ItsLuxer/DRL/Diseños MK1/Dron Simulacion para Matlap/Imagen de la simulacion de matlap.png

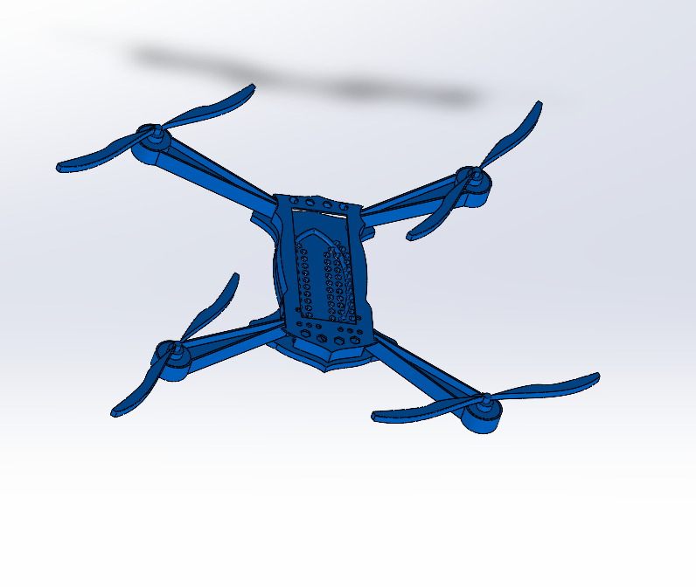
Diseños MK1/Dron Simulacion para Matlap/Imagen de la simulacion de matlap.png
