ItsLuxer/DRL/Planos del DRON png/Brazos del dron semana 3.PNG

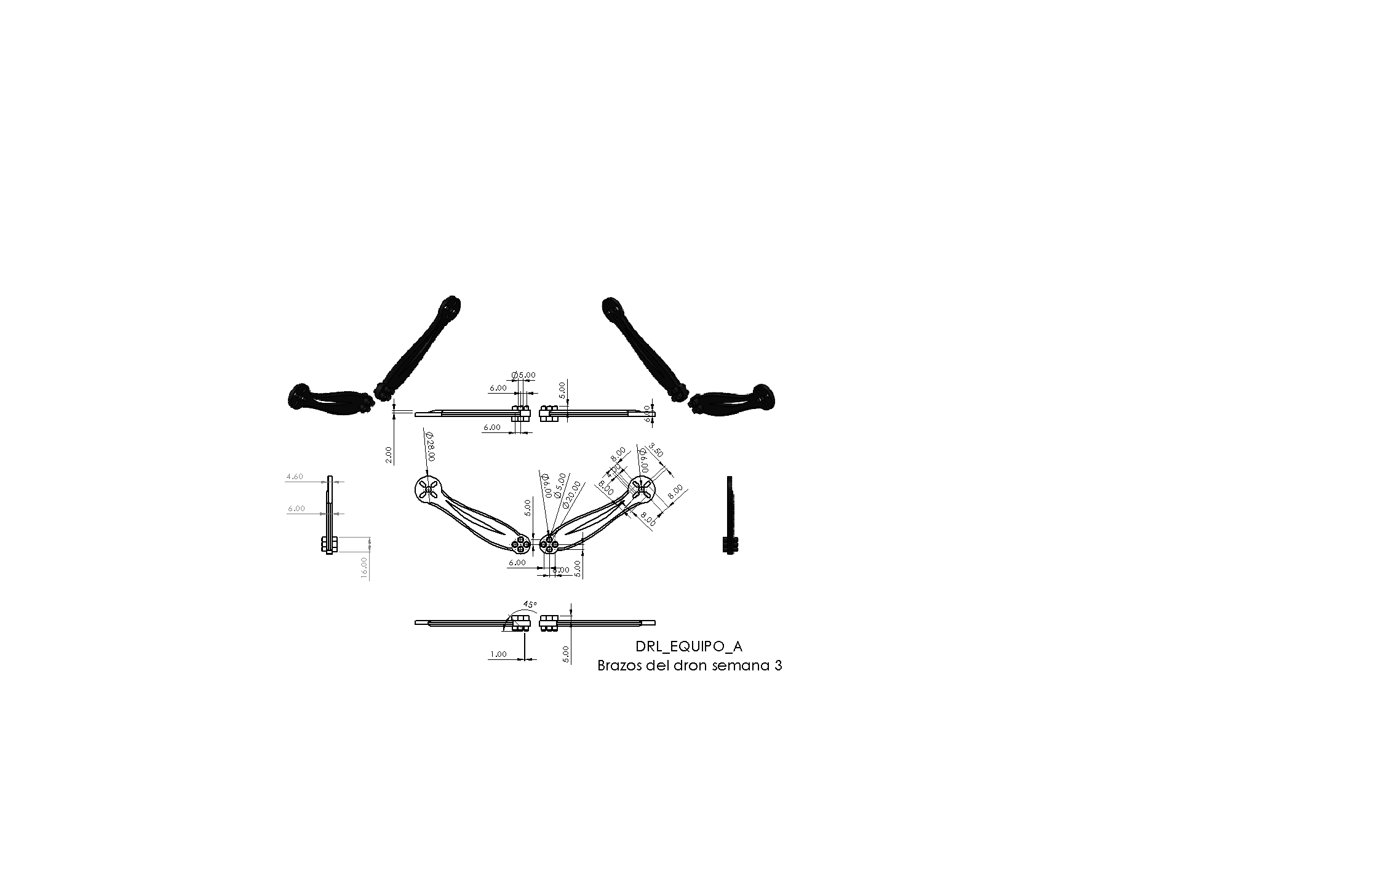
Planos del DRON png/Brazos del dron semana 3.PNG
