ItsLuxer/DRL/Planos del DRON png/Helises.PNG

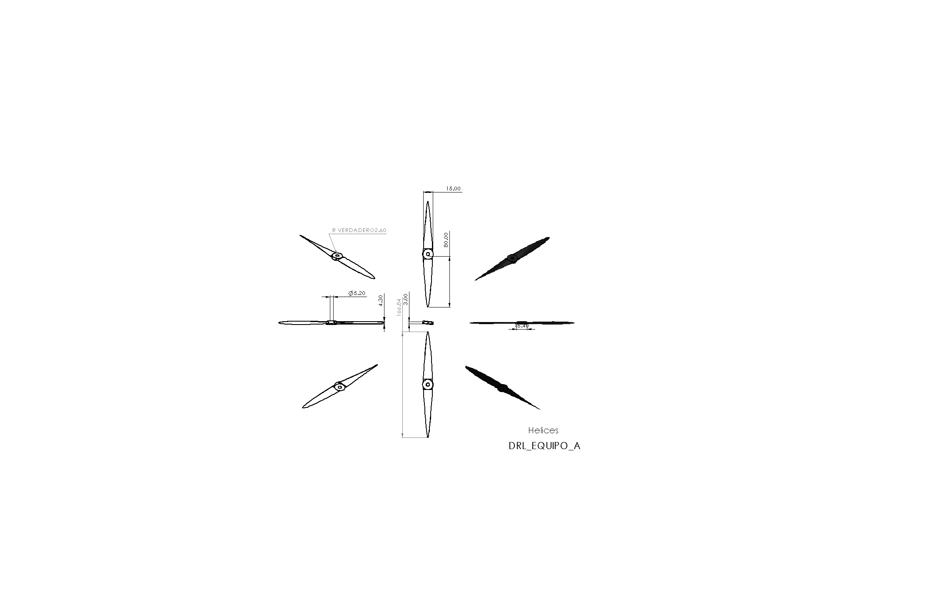
Planos del DRON png/Helises.PNG
