ItsLuxer/DRL/Banco de Pruebas para los motores del dron/Barra Ensamble.SLDPRT

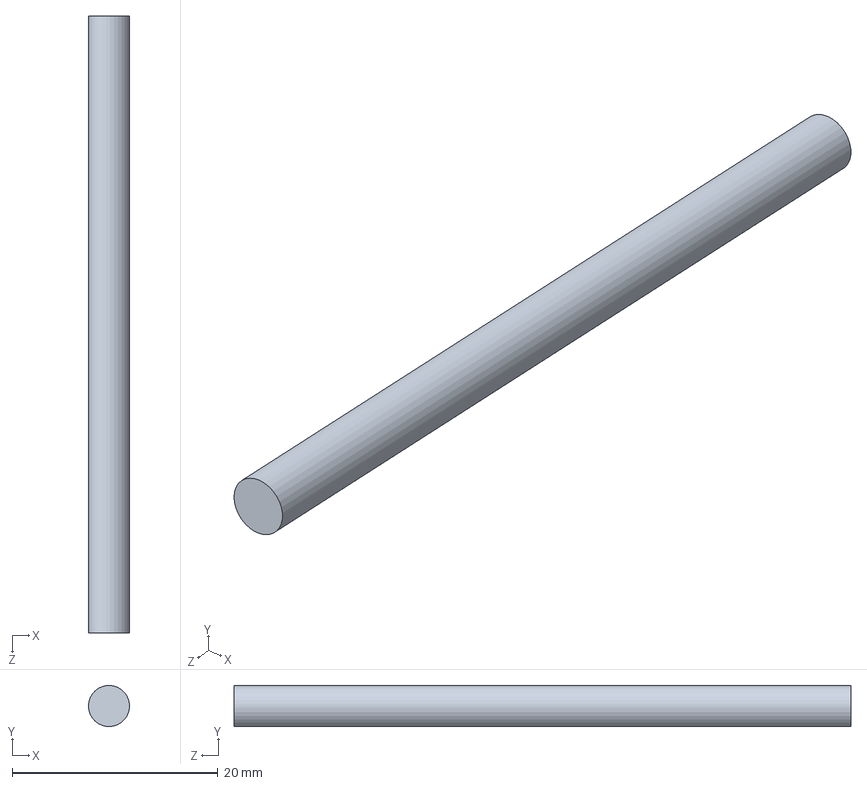
[picture p7: CAD file, 2026-07-15]
Banco de Pruebas para los motores del dron/Barra Ensamble.SLDPRT
4.00 x 3.99 x 60.0 mm
