ItsLuxer/DRL/Banco de Pruebas para los motores del dron/Banco de Pruebas para el motor.SLDASM

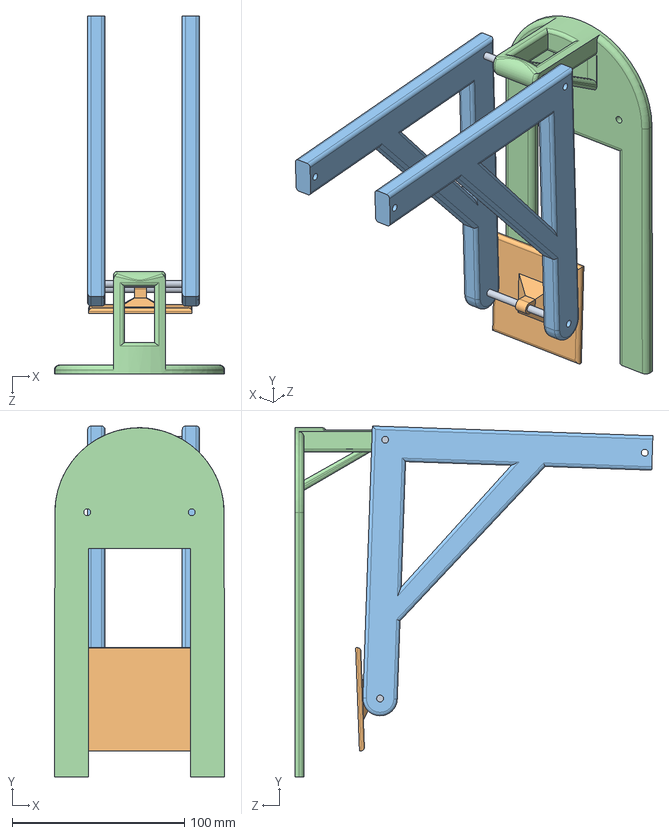
[picture p8: CAD file, 2026-07-15]
Banco de Pruebas para los motores del dron/Banco de Pruebas para el motor.SLDASM
98.9 x 203.8 x 207.8 mm
BASE
Pieza1 x 2
Placa Escale
Barra Ensamble x 2
