ItsLuxer/DRL/Diseños MK1/Dron Simulacion para Matlap/Dron Equipo A.SLDASM

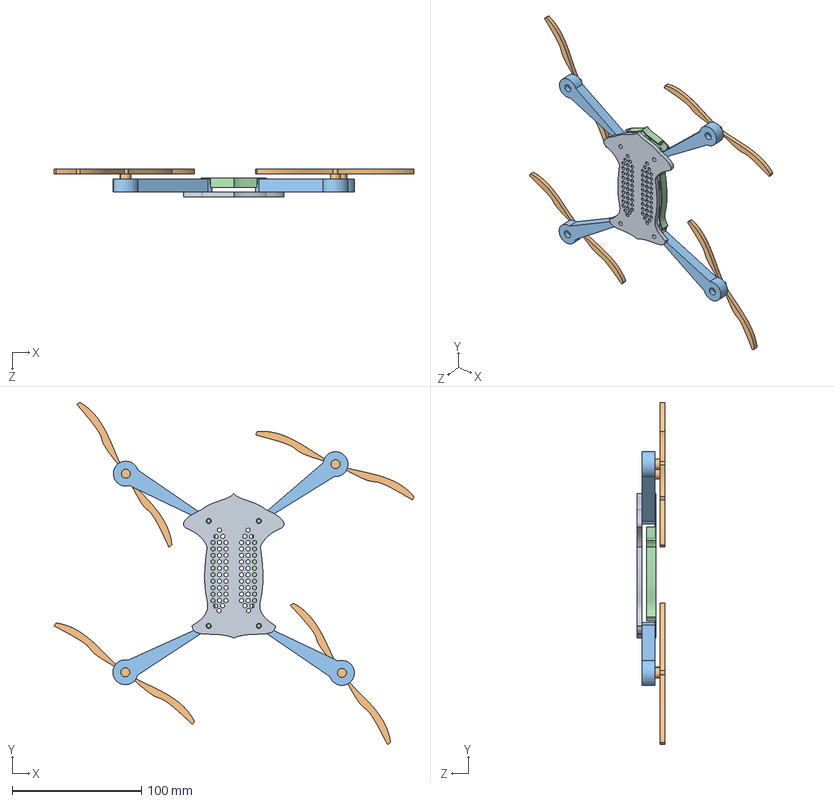
[picture p9: CAD file, 2026-07-13]
Diseños MK1/Dron Simulacion para Matlap/Dron Equipo A.SLDASM
278.8 x 265.1 x 22.0 mm
DrpnBASE
Brazos del dron x 4
Elises x 4
DronSimulacion
