ItsLuxer/DRL/Banco de Pruebas para los motores del dron/BASE.SLDPRT

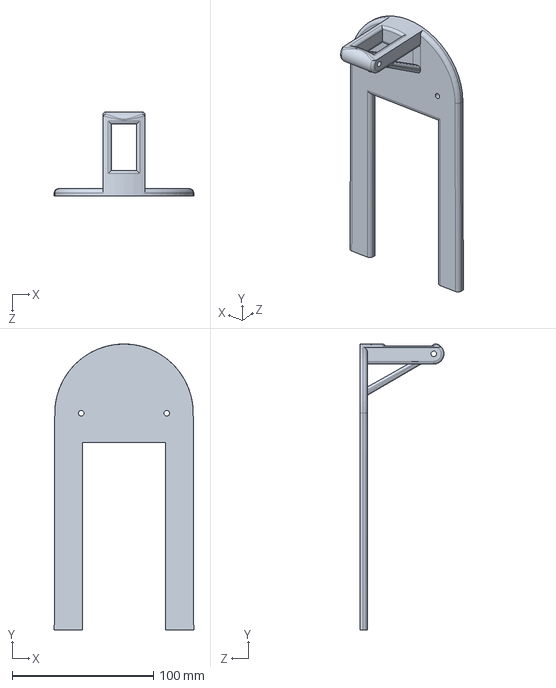
[picture p10: CAD file, 2026-07-15]
Banco de Pruebas para los motores del dron/BASE.SLDPRT
98.9 x 202.8 x 59.5 mm
