ItsLuxer/DRL/Diseños MK1/Dron Simulacion para Matlap/Elises.SLDPRT

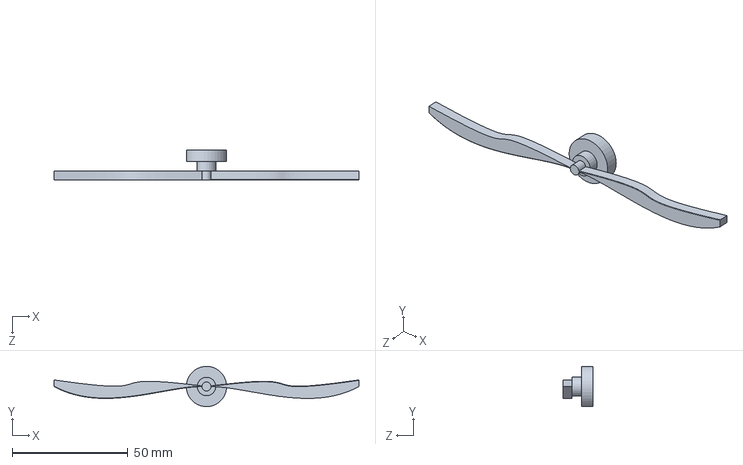
[picture p11: CAD file, 2026-07-16]
Diseños MK1/Dron Simulacion para Matlap/Elises.SLDPRT
131.6 x 17.4 x 13.0 mm
