ItsLuxer/DRL/Dron Semana 3/Segundo piso.SLDPRT

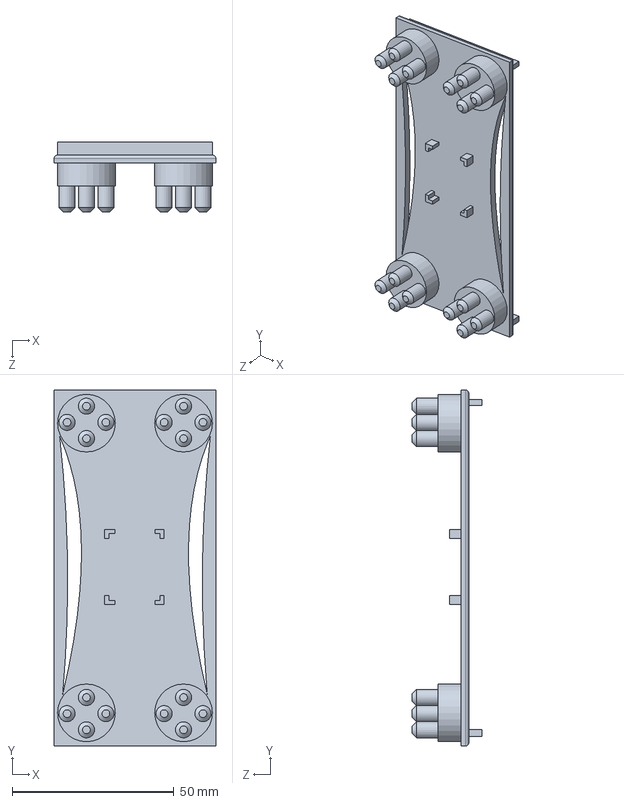
[picture p12: CAD file, 2026-07-24]
Dron Semana 3/Segundo piso.SLDPRT
50.0 x 110.0 x 21.5 mm
