ItsLuxer/DRL/Dron_Digital/MATLAB_DRIVE/Dron_Equipo_A.STL

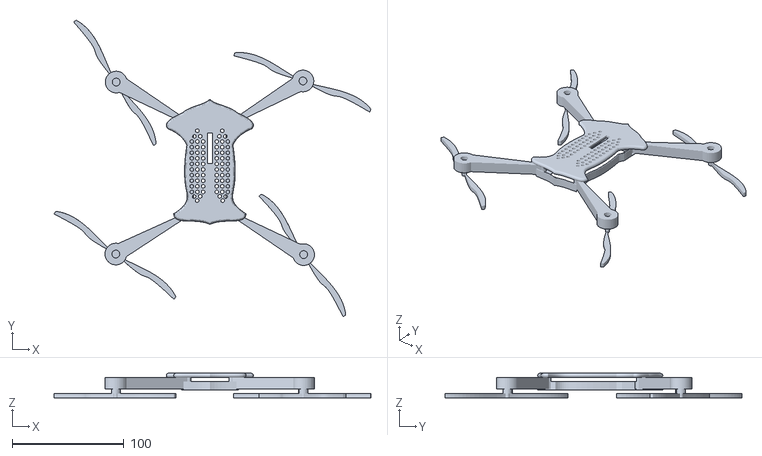
[picture p13: CAD file, 2026-07-11]
Dron_Digital/MATLAB_DRIVE/Dron_Equipo_A.STL
283.2 x 265.0 x 22.0
