ItsLuxer/DRL/Diseños MK1/Dron Simulacion para Matlap/DronSimulacion.SLDPRT

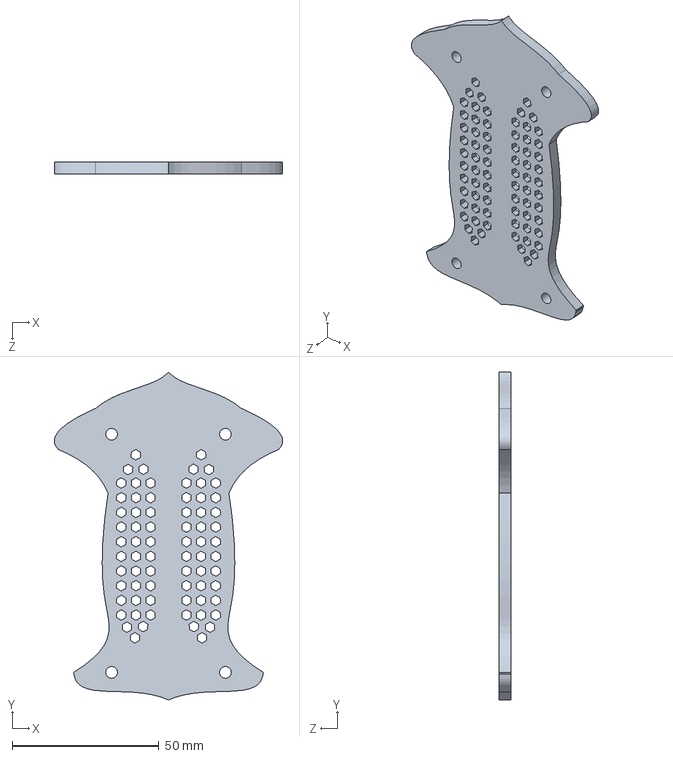
[picture p14: CAD file, 2026-07-16]
Diseños MK1/Dron Simulacion para Matlap/DronSimulacion.SLDPRT
77.9 x 111.8 x 4.00 mm
