ItsLuxer/DRL/Banco de Pruebas para los motores del dron/Placa Escale.SLDPRT

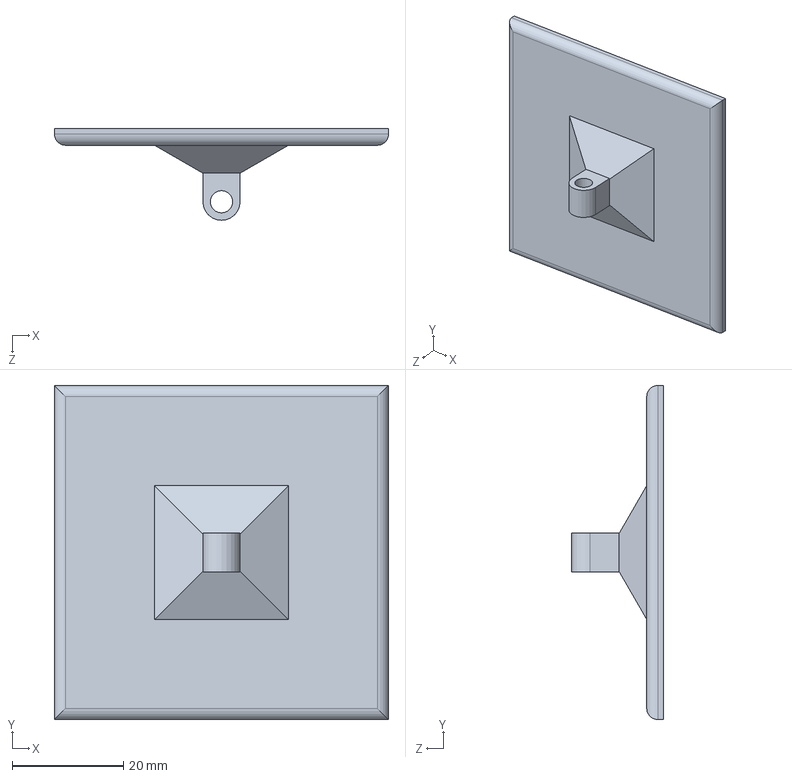
[picture p15: CAD file, 2026-07-15]
Banco de Pruebas para los motores del dron/Placa Escale.SLDPRT
60.0 x 60.0 x 16.5 mm
