ItsLuxer/DRL/Diseños MK1/Dron Simulacion para Matlap/Brazos del dron.SLDPRT

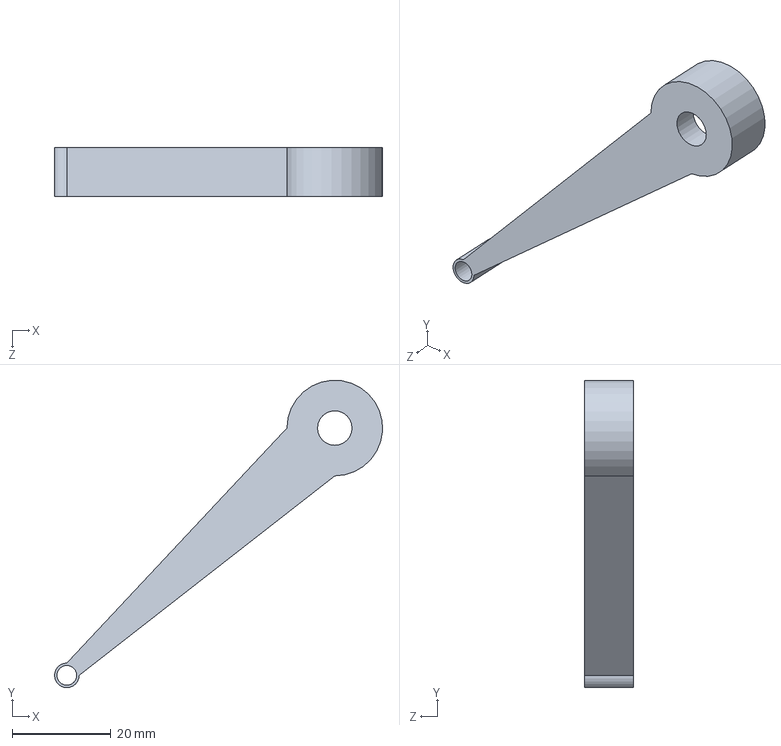
[picture p16: CAD file, 2026-07-16]
Diseños MK1/Dron Simulacion para Matlap/Brazos del dron.SLDPRT
66.5 x 62.3 x 10.0 mm
