ItsLuxer/DRL/Dron Semana 3/Molde de la base Dron semana 3.SLDPRT

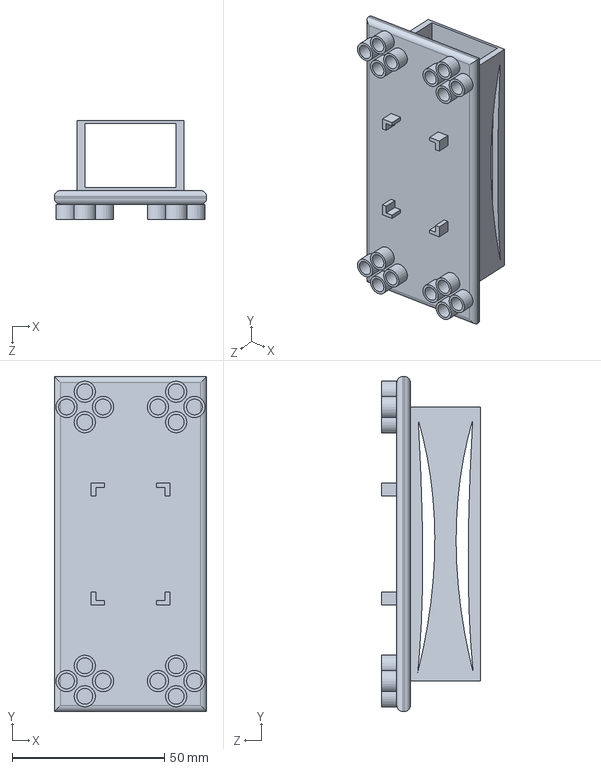
[picture p17: CAD file, 2026-07-22]
Dron Semana 3/Molde de la base Dron semana 3.SLDPRT
50.0 x 110.0 x 32.5 mm
