ItsLuxer/DRL/Diseños MK1/Dron Simulacion para Matlap/DrpnBASE.SLDPRT

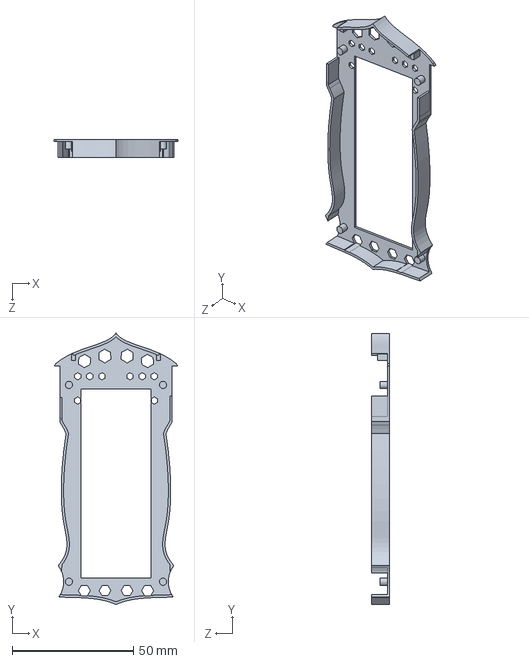
[picture p18: CAD file, 2026-07-16]
Diseños MK1/Dron Simulacion para Matlap/DrpnBASE.SLDPRT
51.0 x 111.8 x 7.60 mm
