ItsLuxer/DRL/Dron Semana 3/Brazos del dron semana 3.SLDPRT

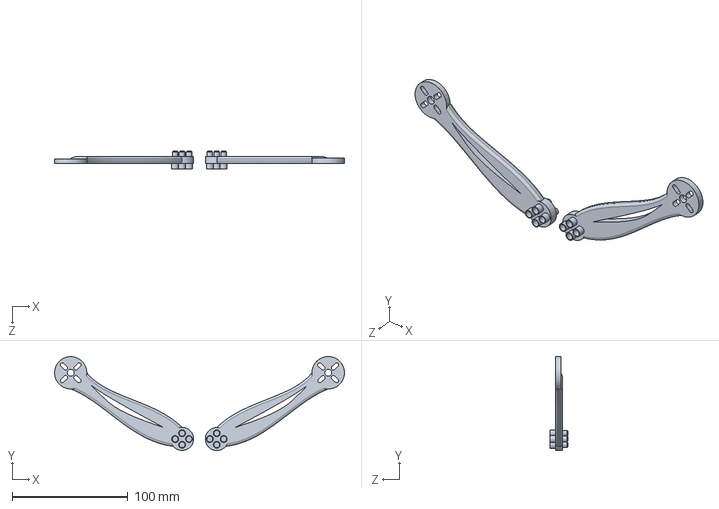
[picture p19: CAD file, 2026-07-22]
Dron Semana 3/Brazos del dron semana 3.SLDPRT
250.9 x 81.4 x 16.0 mm
