ItsLuxer/DRL/Banco de Pruebas para los motores del dron/Pieza1.SLDPRT

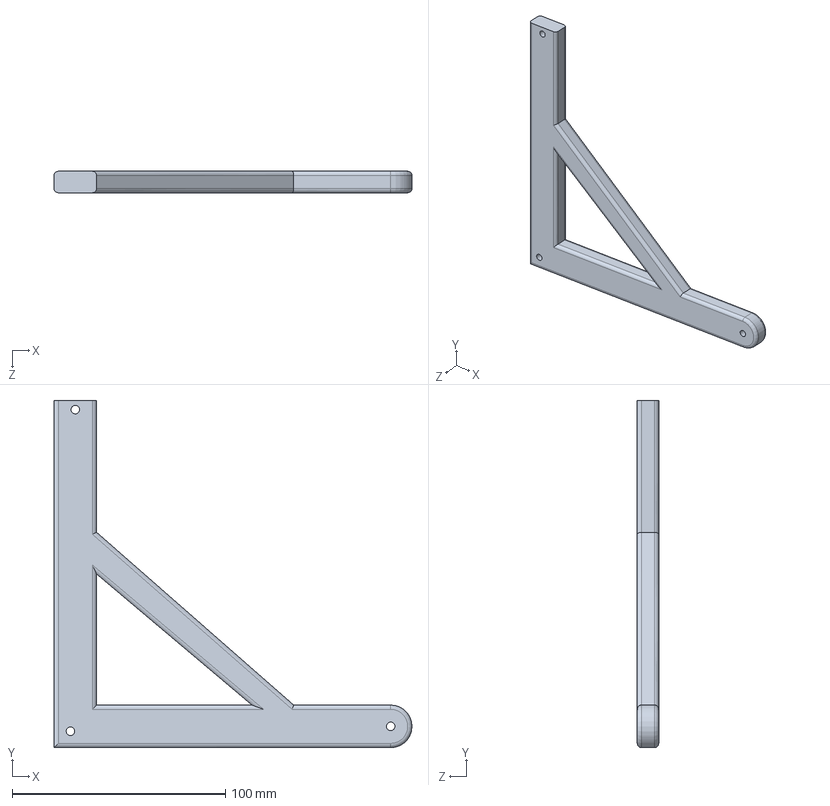
[picture p20: CAD file, 2026-07-15]
Banco de Pruebas para los motores del dron/Pieza1.SLDPRT
168.0 x 163.0 x 10.1 mm
