ItsLuxer/DRL/Dron Semana 3/Ensamblaje Dron semana 3.SLDASM

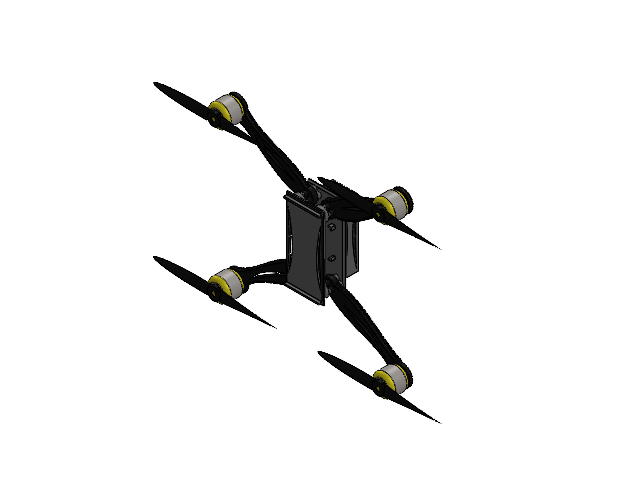
[picture p21: CAD file, 2026-07-22]
Dron Semana 3/Ensamblaje Dron semana 3.SLDASM
Molde de la base Dron semana 3
Brazos del dron semana 3 x 2
Elises de 16 cm x 4
molde del Motor x 4
Segundo piso
