ItsLuxer/DRL/(list of files, cad)

Other CAD files:
Planos de DRON/Brazos del dron semana 3.SLDDRW
Planos de DRON/Ensamblaje Dron semana 3.SLDDRW
Planos de DRON/Helises.SLDDRW
Planos de DRON/Molde de la base Dron semana 3.SLDDRW
Planos de DRON/Segundo piso.SLDDRW
Planos de DRON/molde del Motor.SLDDRW
