ItsLuxer/DRL/Planos del DRON png/Ensamblaje Dron semana 3.PNG

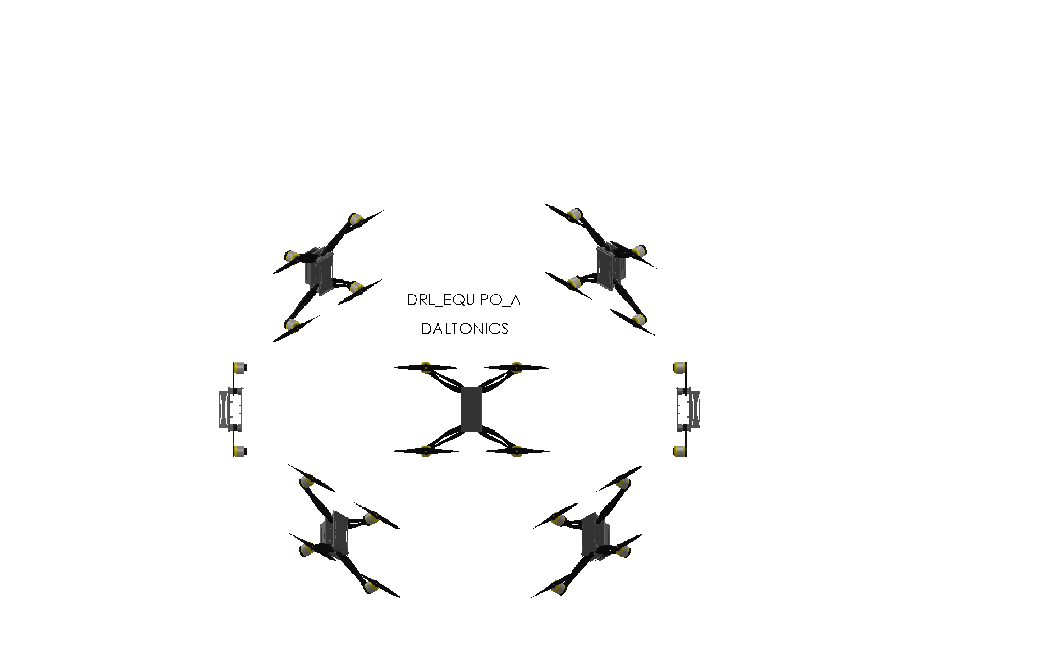
Planos del DRON png/Ensamblaje Dron semana 3.PNG
