ItsLuxer/DRL/(commit log)

2026-07-10 He remplazado la visualizacion del dron, se ajusto la escala para que fuera mas visible
2026-07-10 Depuración de código
2026-07-11 se agrego el mdelo MKI del dron personalizado y se ajustaron sus ejes para que coindicieran con las orientacion del primer modelo de prueba
    [DronNaya.STL, Dron_Equipo_A.STL]
2026-07-13 Se incluyen los archivos originales de diseño y el ensamblaje creados en SolidWorks para permitir la simulación del modelo en matlap
    [Brazos del dron.SLDPRT, Dron Equipo A.SLDASM, DronSimulacion.SLDPRT, DrpnBASE.SLDPRT, Elises.SLDPRT]
2026-07-15 Se agrego el diseño para el banco de pruebas que se utilizara para saber la mejor opcion de elises y componentes
    [BASE.SLDPRT, Banco de Pruebas para el motor.SLDASM, Barra Ensamble.SLDPRT, Pieza1.SLDPRT, Placa Escale.SLDPRT]
2026-07-17 Pin de MAC
2026-07-23 Corrección en la comunicación con mando
2026-07-23 Correcciones PID y estabilidad de vuelo junto a calibracion de motores
2026-07-24 Actualizacion del dron semana 3
    [Segundo piso.SLDPRT]
2026-07-24 Se agregan los planos en .SLDDRW Y PNG del Dron semana 3
    [Brazos del dron semana 3.SLDDRW, Ensamblaje Dron semana 3.SLDDRW, Helises.SLDDRW, Molde de la base Dron semana 3.SLDDRW, Segundo piso.SLDDRW, molde del Motor.SLDDRW]
2026-07-24 Documentar ganancias del gemelo digital como meta de tuneo en el firmware
